winedarksea/solar-necklace-attiny/README.md

# solar-necklace-attiny
Solar Necklace Schematics and ATTiny code

There are two versions here, the original lightsaber necklace and the newer moissanite based version. The attiny code is for the latter.
