winedarksea/solar-necklace-attiny/lightsaber_necklace/lightsaber_necklace.step

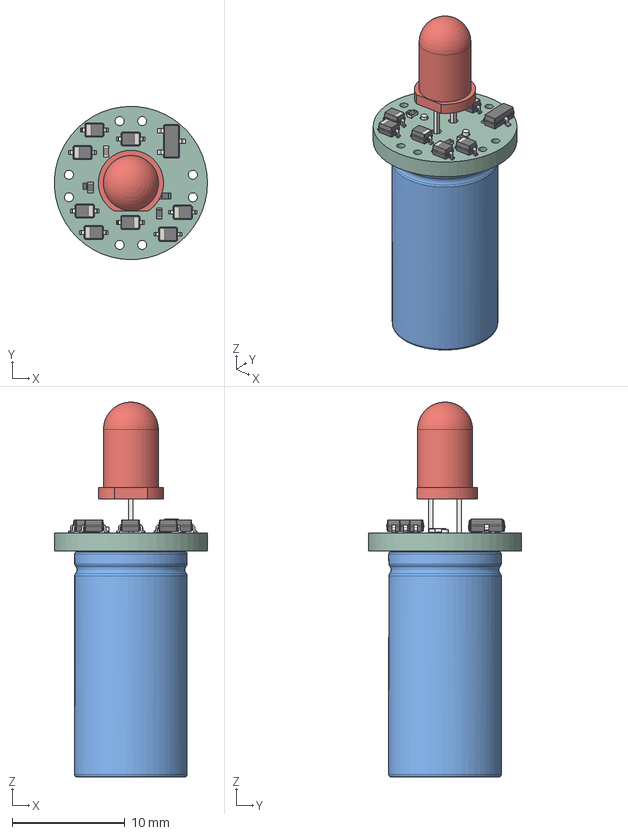
[picture p1: CAD file, 2026-04-20]
lightsaber_necklace/lightsaber_necklace.step
13.6 x 13.6 x 33.3 mm
C_0402_1005Metric
D_SOD_323 x 8
Fuse_0402_1005Metric x 2
LED_D5.0mm
SOT_23
R_0402_1005Metric
R_0201_0603Metric
C_Radial_D100mm_H200mm_P500mm
lightsaber_necklace PCB
