winedarksea/solar-necklace-attiny/solar_necklace_2/lightsaber_necklace.kicad_pcb

## KiCad design solar_necklace_2/lightsaber_necklace.kicad_pcb (2026-04-20)

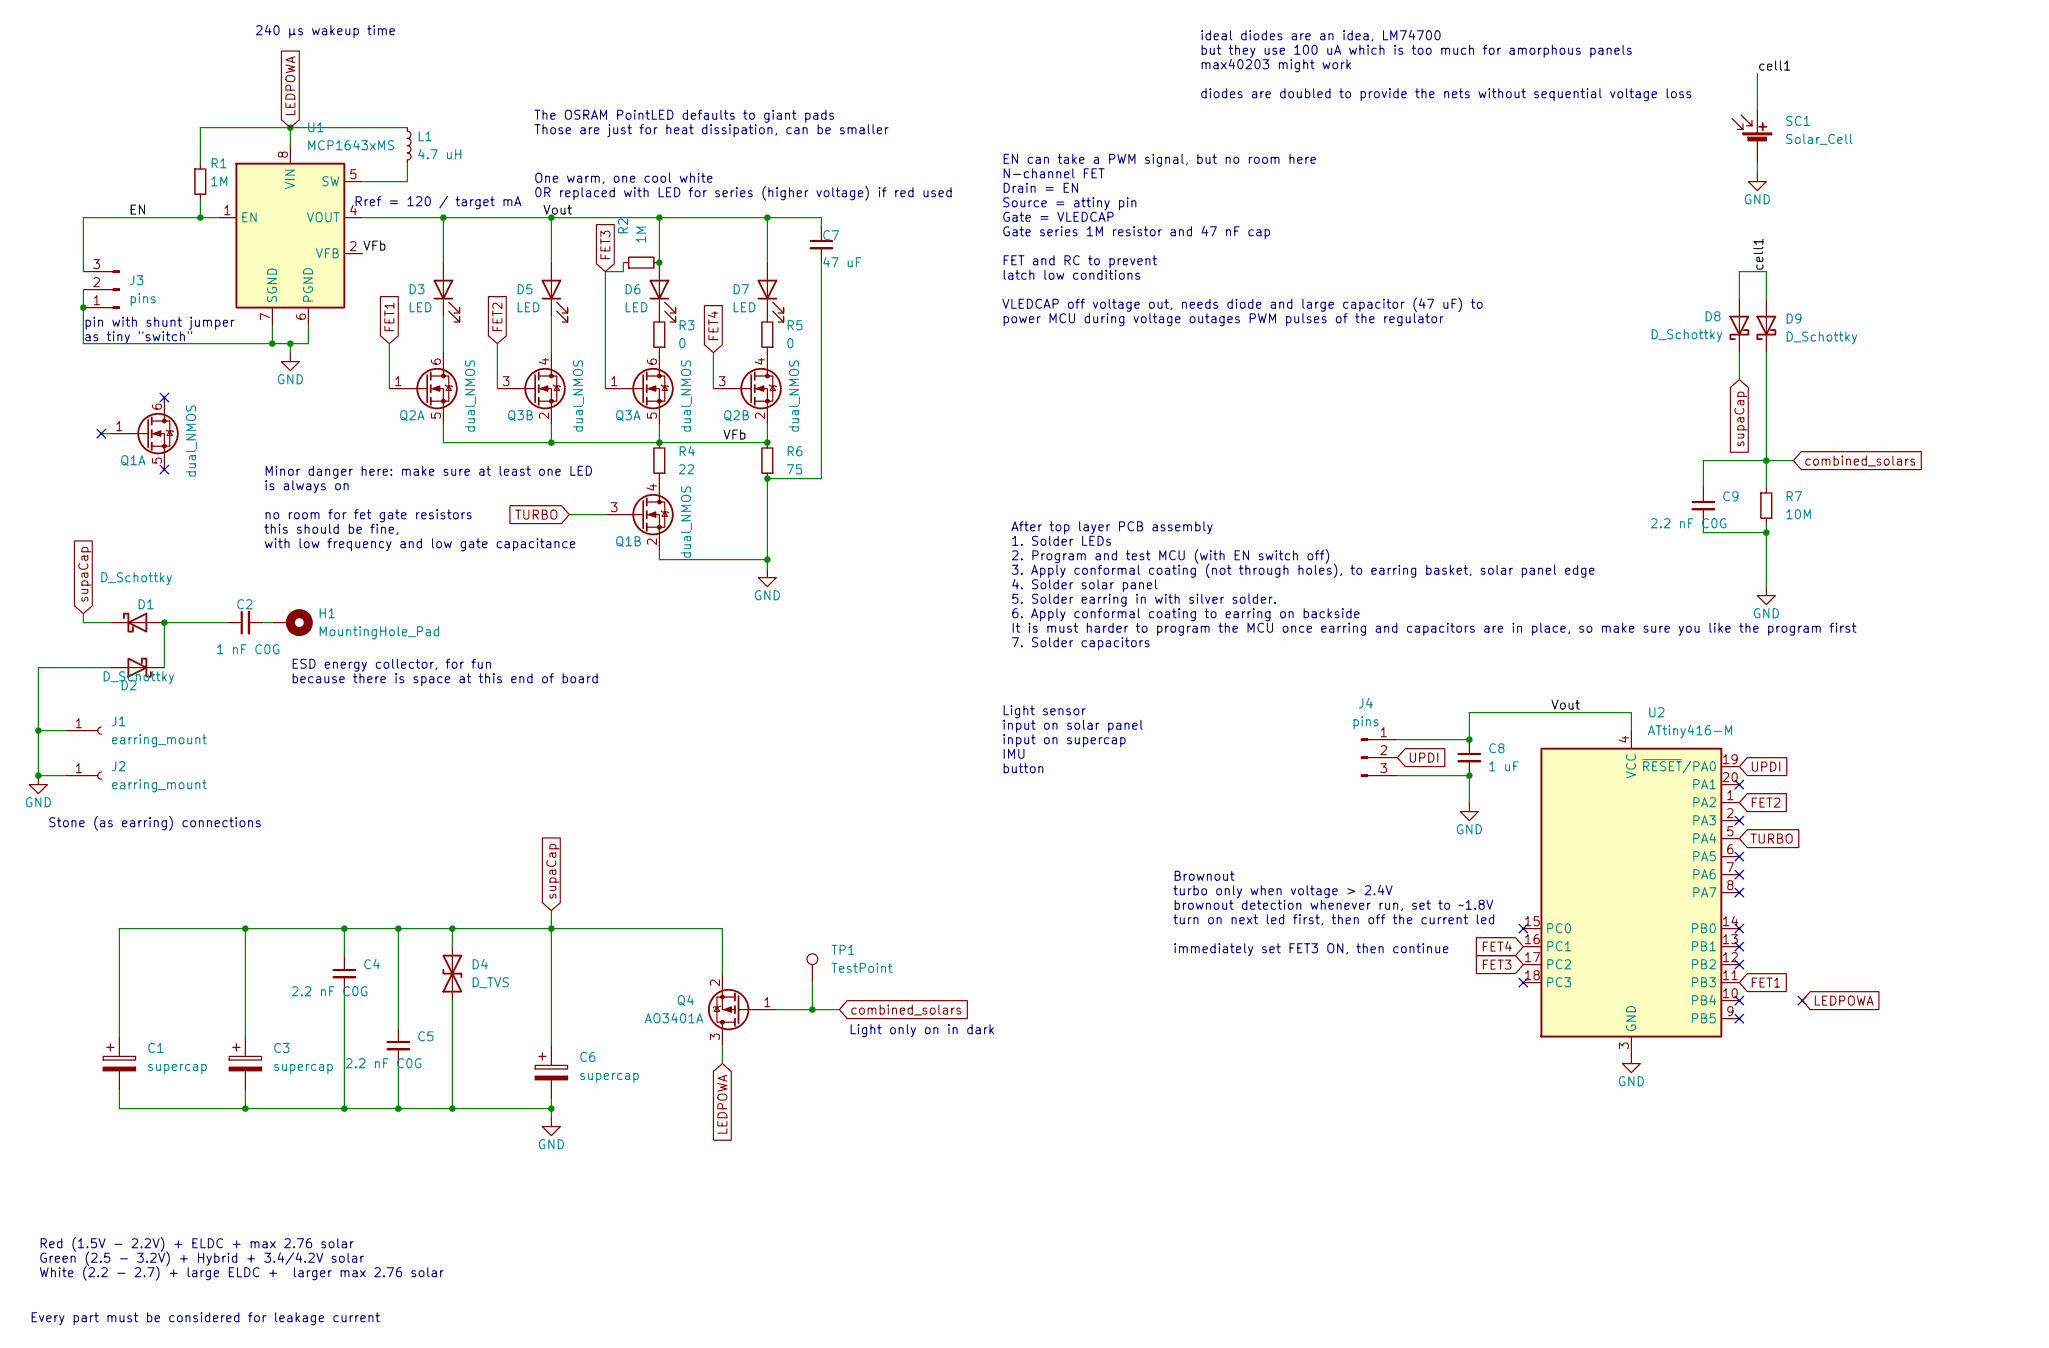
[picture p2: schematic lightsaber_necklace.kicad_sch]

Parts:
C1, C3, C6: supercap; C_Rect_L11.5mm_W9.8mm_P10.00mm_MKT
C2: 1 nF C0G; C_1206_3216Metric
C4, C5, C9: 2.2 nF C0G; C_0805_2012Metric
C7: 47 uF; C_1206_3216Metric
C8: 1 uF; C_0402_1005Metric
D1, D2, D8, D9: D_Schottky; D_SOD-323
D3, D5: LED; LED_1206_3216Metric_ReverseMount_Hole1.8x2.4mm
D4: D_TVS; D_SOD-523
D6, D7: LED; LED_Osram_Lx_P47F_D2mm_ReverseMount
H1: MountingHole_Pad; MountingHole_2.2mm_M2_DIN965_Pad
J1, J2: earring_mount; SolderWire-0.5sqmm_1x01_D0.9mm_OD2.1mm
J3, J4: pins; PinHeader_1x03_P1.27mm_Vertical
L1: 4.7 uH; L_0603_1608Metric
Q1, Q2, Q3: dual_NMOS; SOT-23-6
Q4: AO3401A; SOT-23
R1, R2: 1M; R_0402_1005Metric
R3, R5: 0; R_0603_1608Metric
R4: 22; R_0402_1005Metric
R6: 75; R_0603_1608Metric
R7: 10M; R_0402_1005Metric
SC1: Solar_Cell; PinHeader_1x02_P2.00mm_Vertical
TP1: TestPoint; TestPoint_Pad_D1.0mm
U1: MCP1643xMS; MSOP-8_3x3mm_P0.65mm
U2: ATtiny416-M; VQFN-20-1EP_3x3mm_P0.4mm_EP1.7x1.7mm

Connections:
/EN: J3.3, R1.2, U1.1 (EN)
/VFb: Q2.2 (S), Q2.5 (S), Q3.2 (S), Q3.5 (S), R4.2, R6.2, U1.2 (VFB)
/Vout: C7.1, C8.1, D3.2 (A), D5.2 (A), D6.2 (A), D7.2 (A), J4.1, R2.2, U1.4 (VOUT), U2.4 (VCC)
/cell1: D8.2 (A), D9.2 (A), SC1.1 (+)
FET1: Q2.1 (G), U2.11 (PB3)
FET2: Q3.3 (G), U2.1 (PA2)
FET3: Q3.1 (G), R2.1, U2.17 (PC2)
FET4: Q2.3 (G), U2.16 (PC1)
GND: C1.2, C3.2, C4.2, C5.2, C6.2, C7.2, C8.2, C9.2, D2.2 (A), D4.1 (A1), J1.1, J2.1, J3.1, J3.2, J4.3, Q1.2 (S), R6.1, R7.2, SC1.2 (-), U1.6 (PGND), U1.7 (SGND), U2.3 (GND), U2.21 (GND)
LEDPOWA: L1.1, Q4.3 (D), R1.1, U1.8 (VIN)
unnamed: C2.2, H1.1
unnamed: C2.1, D1.2 (A), D2.1 (K)
unnamed: D3.1 (K), Q2.6 (D)
unnamed: D5.1 (K), Q3.4 (D)
unnamed: D6.1 (K), R3.2
unnamed: D7.1 (K), R5.2
unnamed: Q1.4 (D), R4.1
unnamed: Q2.4 (D), R5.1
unnamed: Q3.6 (D), R3.1
unnamed: L1.2, U1.5 (SW)
TURBO: Q1.3 (G), U2.5 (PA4)
UPDI: J4.2, U2.19 (~RESET/PA0)
combined_solars: C9.1, D9.1 (K), Q4.1 (G), R7.1, TP1.1
supaCap: C1.1, C3.1, C4.1, C5.1, C6.1, D1.1 (K), D4.2 (A2), D8.1 (K), Q4.2 (S)

Notes on the sheet:
ideal diodes are an idea, LM74700 but they use 100 uA which is too much for amorphous panels max40203 might work diodes are doubled to provide the nets without sequential voltage loss
Every part must be considered for leakage current
EN can take a PWM signal, but no room here N-channel FET Drain = EN Source = attiny pin Gate = VLEDCAP Gate series 1M resistor and 47 nF cap FET and RC to prevent latch low conditions VLEDCAP off voltage out, needs diode and large capacitor (47 uF) to power MCU during voltage outages PWM pulses of 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
Red (1.5V - 2.2V) + ELDC + max 2.76 solar Green (2.5 - 3.2V) + Hybrid + 3.4/4.2V solar White (2.2 - 2.7) + large ELDC + larger max 2.76 solar
Light only on in dark
The OSRAM PointLED defaults to giant pads Those are just for heat dissipation, can be smaller
Rref = 120 / target mA
After top layer PCB assembly 1. Solder LEDs 2. Program and test MCU (with EN switch off) 3. Apply conformal coating (not through holes), to earring basket, solar panel edge 4. Solder solar panel 5. Solder earring in with silver solder. 6. Apply conformal coating to earring on backside It is must ha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
Minor danger here: make sure at least one LED is always on no room for fet gate resistors this should be fine, with low frequency and low gate capacitance
One warm, one cool white 0R replaced with LED for series (higher voltage) if red used
240 µs wakeup time
Brownout turbo only when voltage > 2.4V brownout detection whenever run, set to ~1.8V turn on next led first, then off the current led immediately set FET3 ON, then continue
Light sensor input on solar panel input on supercap IMU button
pin with shunt jumper as tiny "switch"
Stone (as earring) connections
ESD energy collector, for fun because there is space at this end of board

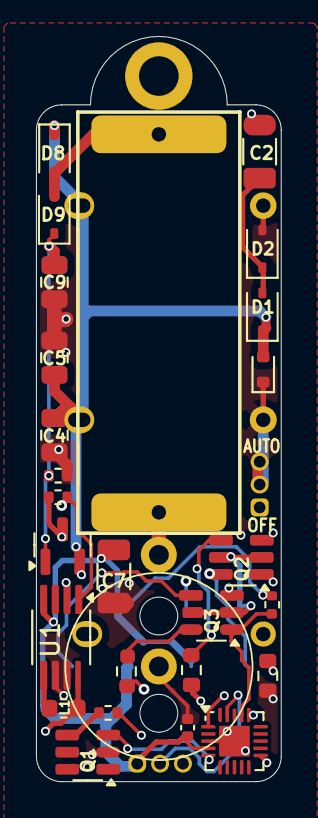
[picture p3: board solar_necklace_2/lightsaber_necklace.kicad_pcb from above]

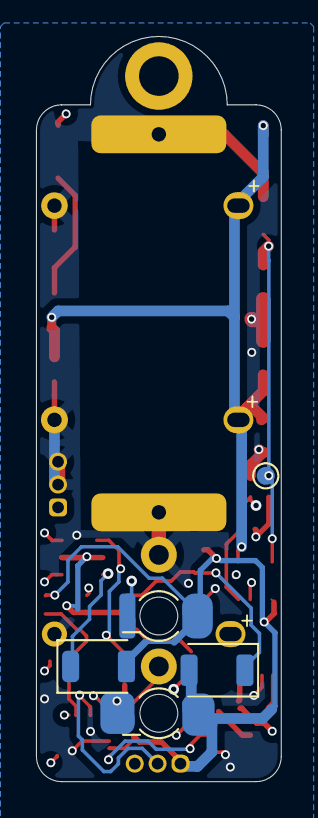
[picture p4: board solar_necklace_2/lightsaber_necklace.kicad_pcb from below]

Board: 4 copper layers, 13.6 x 41.4 mm, 39 parts (8 on the bottom side), 24 nets.
