winedarksea/solar-necklace-attiny/lightsaber_necklace/lightsaber_necklace.kicad_pcb

## KiCad design lightsaber_necklace/lightsaber_necklace.kicad_pcb (2026-04-20)

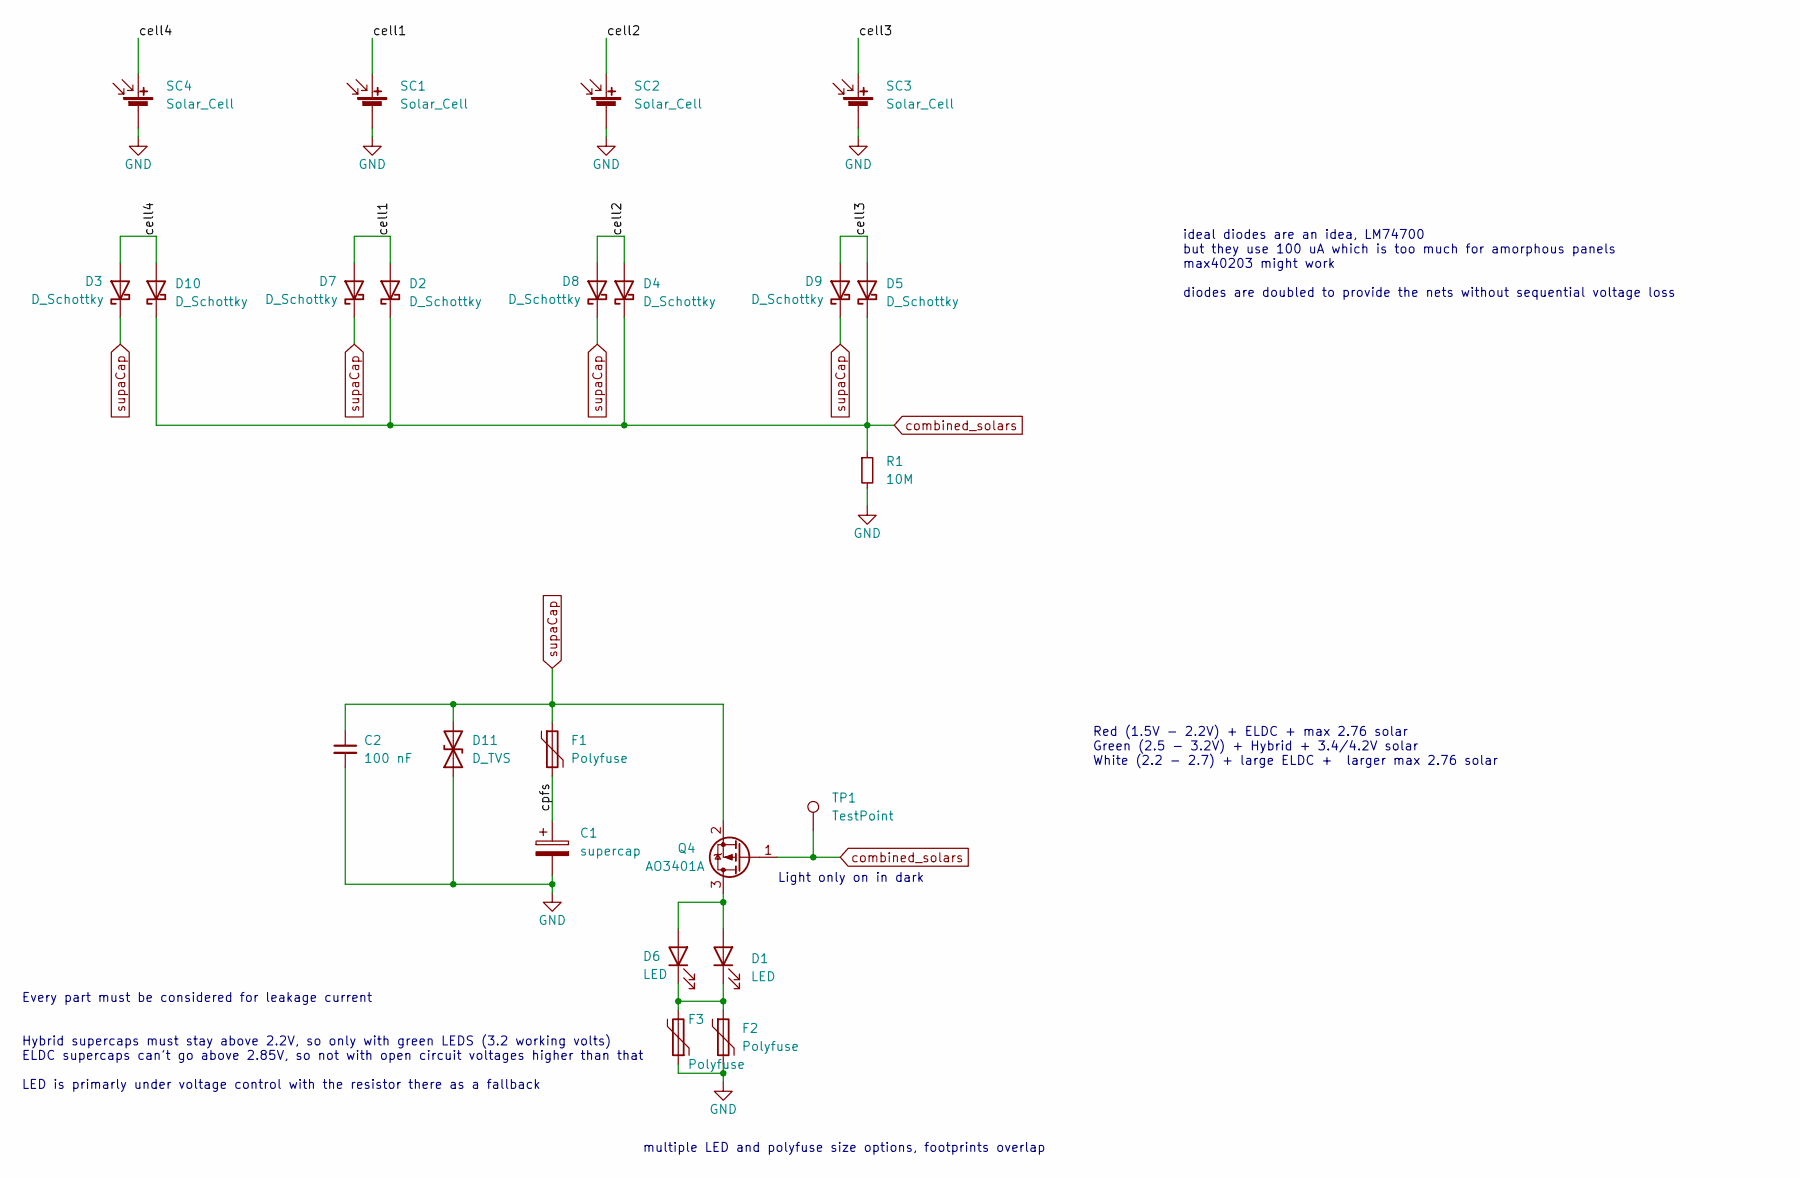
[picture p5: schematic lightsaber_necklace.kicad_sch]

Parts:
C1: supercap; C_Radial_D10.0mm_H20.0mm_P5.00mm
C2: 100 nF; C_0402_1005Metric
D1: LED; LED_PLCC_2835
D2, D3, D4, D5, D7, D8, D9, D10: D_Schottky; D_SOD-323
D6: LED; LED_D5.0mm
D11: D_TVS; D_0402_1005Metric
F1: Polyfuse; Fuse_0402_1005Metric_Pad0.77x0.64mm_HandSolder
F2: Polyfuse; R_0201_0603Metric_Pad0.64x0.40mm_HandSolder
F3: Polyfuse; Fuse_0402_1005Metric
Q4: AO3401A; SOT-23
R1: 10M; R_0402_1005Metric
SC1, SC2, SC3, SC4: Solar_Cell; PinHeader_1x02_P2.00mm_Vertical
TP1: TestPoint; TestPoint_Pad_D1.0mm

Connections:
/cell1: D2.2 (A), D7.2 (A), SC1.1 (+)
/cell2: D4.2 (A), D8.2 (A), SC2.1 (+)
/cell3: D5.2 (A), D9.2 (A), SC3.1 (+)
/cell4: D3.2 (A), D10.2 (A), SC4.1 (+)
/cpfs: C1.1, F1.2
GND: C1.2, C2.2, D11.1 (A1), F2.2, F3.1, R1.2, SC1.2 (-), SC2.2 (-), SC3.2 (-), SC4.2 (-)
unnamed: D1.2 (A), D6.2 (A), Q4.3 (D)
unnamed: D1.1 (K), D6.1 (K), F2.1, F3.2
combined_solars: D2.1 (K), D4.1 (K), D5.1 (K), D10.1 (K), Q4.1 (G), R1.1, TP1.1
supaCap: C2.1, D3.1 (K), D7.1 (K), D8.1 (K), D9.1 (K), D11.2 (A2), F1.1, Q4.2 (S)

Notes on the sheet:
ideal diodes are an idea, LM74700 but they use 100 uA which is too much for amorphous panels max40203 might work diodes are doubled to provide the nets without sequential voltage loss
Every part must be considered for leakage current Hybrid supercaps must stay above 2.2V, so only with green LEDS (3.2 working volts) ELDC supercaps can't go above 2.85V, so not with open circuit voltages higher than that LED is primarly under voltage control with the resistor there as a fallback
Red (1.5V - 2.2V) + ELDC + max 2.76 solar Green (2.5 - 3.2V) + Hybrid + 3.4/4.2V solar White (2.2 - 2.7) + large ELDC + larger max 2.76 solar
multiple LED and polyfuse size options, footprints overlap
Light only on in dark

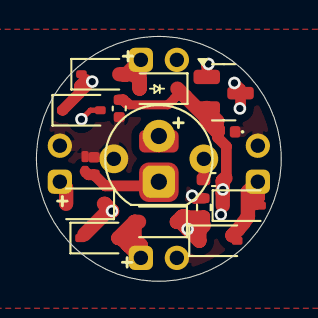
[picture p6: board lightsaber_necklace/lightsaber_necklace.kicad_pcb from above]

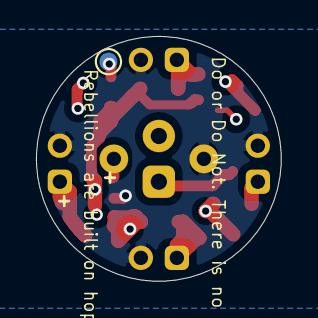
[picture p7: board lightsaber_necklace/lightsaber_necklace.kicad_pcb from below]

Board: 4 copper layers, 13.6 x 13.6 mm, 23 parts (2 on the bottom side), 10 nets.
