winedarksea/solar-necklace-attiny/(commit log)

2026-04-12 Build 1: Opus 4.6
    [lightsaber_necklace.kicad_sch]
2026-04-12 Build 2: desperate power saving measures
2026-04-20 upload schematics
    [bom.csv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]
2026-04-20 minor fix that didn't make it to gerbers
    [lightsaber_necklace-B_Cu.gbr, lightsaber_necklace-B_Mask.gbr, lightsaber_necklace-B_Paste.gbr, lightsaber_necklace-B_Silkscreen.gbr, lightsaber_necklace-Edge_Cuts.gbr, lightsaber_necklace-F_Cu.gbr, lightsaber_necklace-F_Mask.gbr, lightsaber_necklace-F_Paste.gbr]
